LeoPersike/ProjetoAcionamentoLampadasRF/Manual de instruções.pdf

## Acionador automático de lâmpadas via RF

Projetista: Leonardo Persike Martins
Email: Leonardo.Persike.Martins@gmail.com

Descrição de funcionamento
O equipamento em questão se trata de um conjunto de dispositivos cujo comportamento baseia-se em um sensor de barreira, utilizado para a detecção de objetos que interrompem um feixe de luz infravermelha. Quando acionado, o dispositivo base envia um sinal de acionamento via rádio frequência para um totem contendo uma lâmpada, acionando assim a mesma por um determinado período de tempo. No caso do sistema em questão, foi planejada a utilização de dois totens, os quais serão acionados de forma aleatória e exclusiva (apenas um totem por vez).

## Sumário

Acionador automático de lâmpadas via RF | 1
Descrição de funcionamento | 1
Sumário | 1
Lista de componentes | 2
Ferramentas necessárias | 3
Diagrama de conexões | 4
Sensor de barreira - Receptor | 4
Sensor de barreira - Transmissor | 4
Totem Luz | 4
Instruções adicionais | 5
Totem de luz | 5
Transmissor e receptor RF | 5
Antena | 5
Programação do microcontrolador | 6
Preparando a interface Arduino | 6
Programando | 6
Baixando o código | 6
Preparação do sistema | 7
Inserindo código no relé | 7
Clonando código do controle no Arduino | 7

Acionador automático de lâmpadas via RF
Leonardo.Persike.Martins@gmail.com

## Lista de componentes

Os seguintes itens fazem parte de um sistema completo com 2 totens de luz:

Item | Qtd. | Link | Descrição
Placa Arduíno Nano | 1 | Arduíno (https://www.filipeflop.com/produto/placa-nano-v3-0-cabo-usb-para-arduino/) | Módulo contendo microcontrolador que servirá como inteligência do sistema.
Módulo Transmissor RF 433MHz | 1 | Módulo RF (https://www.filipeflop.com/produto/modulo-rf-transmissor-receptor-433mhz-am/) | Módulo RF que opera como um controle.
Antena 433MHz | 1 | Antena 433MHz (https://www.filipeflop.com/produto/antena-espiral-433mhz/) | Antena para ser soldada no módulo RF de forma a aumentar o alcance do mesmo.
Módulo Relé 2 (ou mais) canais controlado por RF | 2 | Relé (https://www.filipeflop.com/produto/modulo-rele-4-canais-interruptor-com-controle-remoto-rf-433mhz/) | Relés conectados aos totens de luz, de forma a receber e interpretar o sinal, acionando e desligando as luzes.
Módulo conversor de tensão 12V para 5V | 1 | Conversor (https://www.filipeflop.com/produto/conversor-step-down-9-36vdc-para-5v-6a-usb/) | Conversor para reduzir a tensão da bateria para 5V, de forma a alimentar os microcontroladores.
Sensor de barreira 12V | 1 | Sensor Barreira (https://www.magazineluiza.com.br/sensor-antiesmagamento-barreira-feixe-simples-ativo-ir15-ipec/p/ha85a4d629/cj/seps/) | Sensor de barreira para detectar a passagem do veículo.
Bateria 12V | 4 | Bateria (https://www.magazineluiza.com.br/bateria-selada-12v-13ah-nobreak-cerca-eletrica-alarmes-relogio-de-ponto-balancas-secpower/p/hcc62h2gfb/au/otau/) | Bateria para alimentar os sistemas.
Módulo carregador de bateria 12V | 4 | Carregador (https://www.magazineluiza.com.br/modulo-fonte-flex-carregador-bateria-12v-emergencia-boosmce/p/fk2gdcaa43/te/cdcl/) | Módulo para carregamento das baterias.
Fonte 12V | 4 | Fonte 12V (https://www.magazineluiza.com.br/fonte-carregador-12v-3a-plug-5-5x2-5-173/p/jda0aj47gc/te/cdcl/) | Fonte para carregar as baterias diretamente pela tomada.
Refletor LED 12V | 2 | Refletor (https://www.magazineluiza.com.br/kit-2-farol-milha-16-leds-48w-12v-24v-quadrado-off-road-6000k-ry/p/ek9cfg9e92/au/otau/) | Refletores que serão colocados nos totens.
Chave Liga/Desliga | 4 | Chave on off (https://www.filipeflop.com/produto/chave-gangorra-redonda-on-off-spst/) | Botão para ligar e desligar o sistema.
Conectores rápidos | 8 | Conector (https://www.filipeflop.com/produto/emenda-rapida-para-fios/) | Conector 2 vias para distribuição de cabos internamente.
Jumpers | 2 | Jumpers (https://www.filipeflop.com/produto/kit-jumpers-10cm-x120-unidades/) | Jumpers necessários para a interconexão entre componentes.
Cabo PP 2 vias | 2 | Cabo PP (https://www.magazineluiza.com.br/cabo-fio-pp-500v-2-vias-2x150mm-rolo-com-1-metros-sil/p/dgk4f2g6f4/cj/catr/) | Cabo 2.5mm (ou mais grosso) para distribuir a alimentação do sistema
Par de garras jacaré | 1 | Garras (https://www.magazineluiza.com.br/garra-jacare-35mm-isolado-preta-e-vermelha-10-pares-de-coracao-shop/p/jefka173kj/au/gjcr/) | Garras jacaré para conexão da bateria.

## Ferramentas necessárias

As seguintes ferramentas são necessárias para a montagem dos equipamentos.

Item | Link | Descrição
Ferro de solda | Ferro (https://www.magazineluiza.com.br/ferro-solda-soldar-estanho-60w-inmetro-127-220v-profissional-eda/p/dcbc94fe0g/fs/fdsa/) | Utilizado para soldar as garras jacarés nos cabos que vão para a bateria.
Estanho | Estanho (https://www.magazineluiza.com.br/estanho-fio-c-fluxo-10mm-tubinho-cobix/p/gj38ed20f8/in/pepc/) | Utilizado para soldar as garras jacarés nos cabos que vão para a bateria.
Alicate corte | Alicate (https://www.magazineluiza.com.br/alicate-de-corte-diagonal-profissional-mtx/p/cfed703fgb/fs/altd/) | Utilizado para descascar os cabos.
Chave philips | Kit (https://www.magazineluiza.com.br/conjunto-kit-de-chaves-de-precisao-25-pecas-ima-conserto-manutencao-de-celular-computador-notebook-chaves-universal/p/ddcf1fc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) | Utilizado para conectar os cabos aos conectores das placas.

## Diagrama de conexões

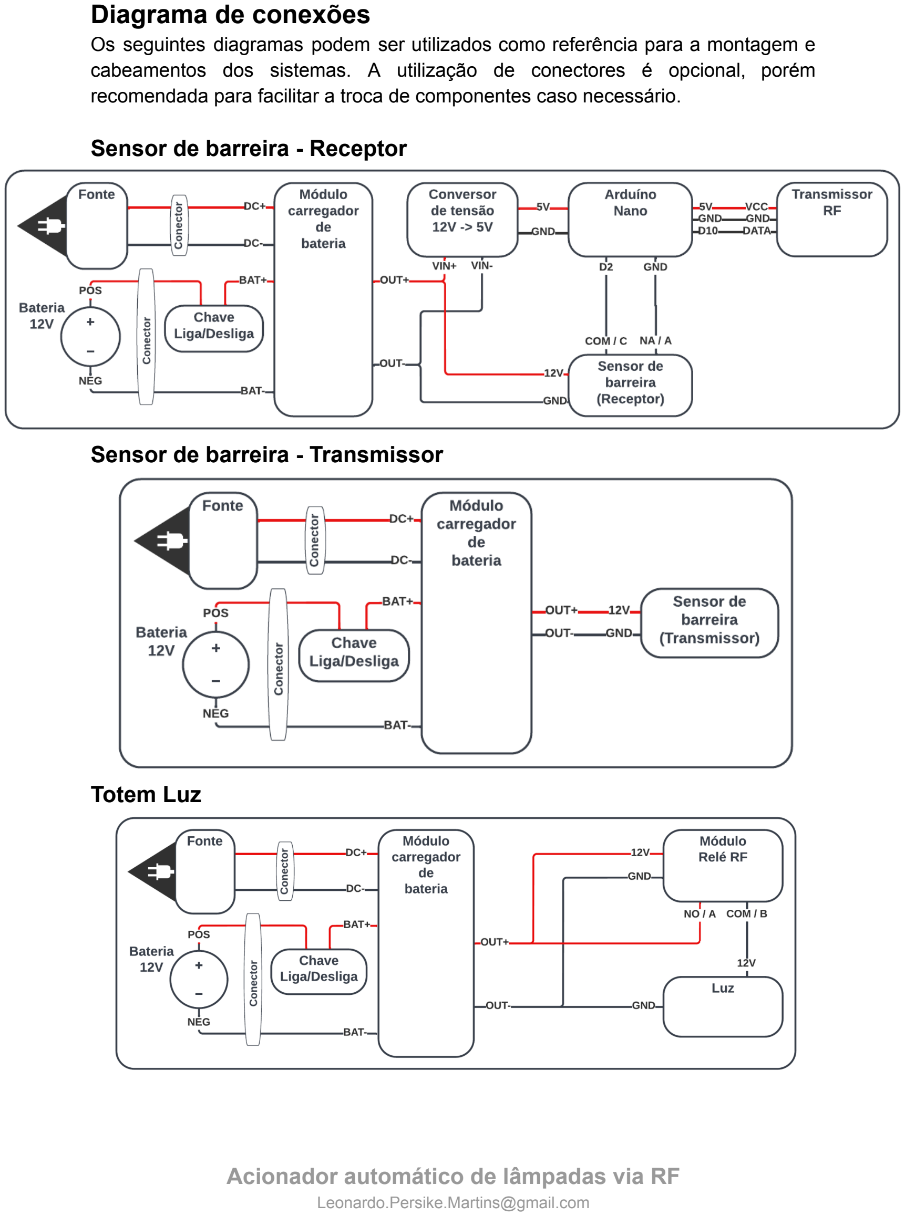
[picture p1: page 4]

Os seguintes diagramas podem ser utilizados como referência para a montagem e cabeamentos dos sistemas. A utilização de conectores é opcional, porém recomendada para facilitar a troca de componentes caso necessário.

Sensor de barreira - Receptor

Sensor de barreira - Transmissor

Totem Luz

Instruções adicionais
Totem de luz
O sistema tem a capacidade de acionamento de quatro totens de luz diferentes, devido a placa de relé conter 4 relés. Portanto, a conexão dos refletores devem seguir o seguinte diagrama:

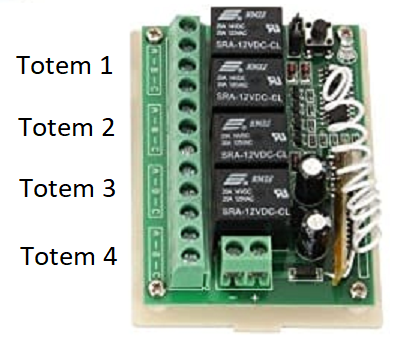
[picture p2: figure]

Transmissor e receptor RF
A seguinte imagem identifica os componentes:

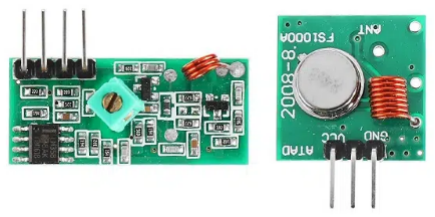
[picture p3: figure]

Receptor à esquerda. Transmissor à direita.

Antena
De forma a melhorar o alcance do módulo RF, é possível realizar a soldagem de uma antena simples no pino “ANT” do módulo transmissor, conforme indica a imagem a seguir:

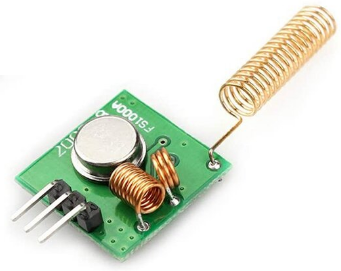
[picture p4: figure]

## Programação do microcontrolador

Preparando a interface Arduino
Para a programação dos microcontroladores será utilizada a interface de desenvolvimento (IDE) Arduino, que pode ser obtida através do seguinte link:
- https://www.arduino.cc/en/software

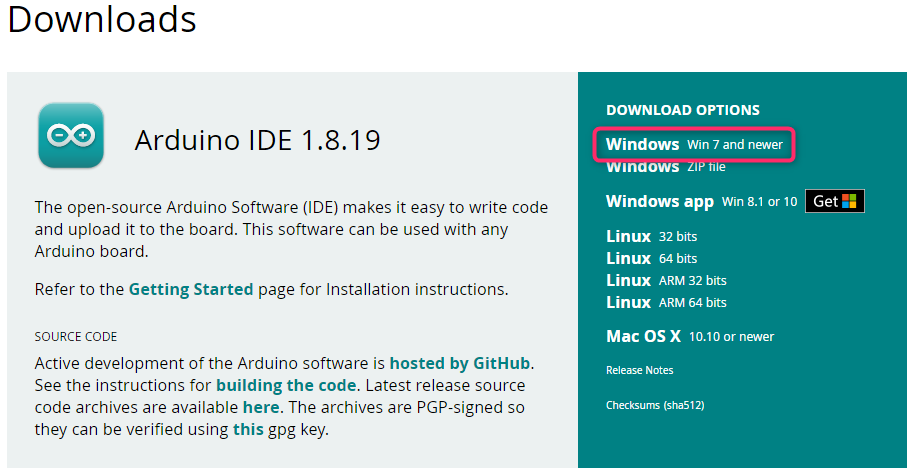
[picture p5: figure]

Programando
Para programar o microcontrolador é necessário uma conexão USB entre o dispositivo e o computador. Note que a programação pode ser feita antes de montar o sistema, facilitando assim o acesso ao conector USB da placa.

Baixando o código
- Abrir o site: https://github.com/LeoPersike/ProjetoAcionamentoLampadasRF
- Faça o download dos códigos clicando em “Code”->”Download Zip”
- Em seguida extraia o arquivo e abra a pasta “acionadorRF”
- Abra o software “Arduino” ou dê dois cliques no arquivo “acionadorRF.ino”

Programando o Arduino
- Conecte o Arduino com o cabo USB no PC
- Selecionar a placa arduino Nano: “Tools” -> “Board: xxx” -> Arduino Nano
- Selecionar a porta em que o dispositivo está conectado: “Tools” -> “Port” -> “COM X”
- Clicar em “Sketch” -> “Upload”
- A seguinte mensagem deverá aparecer:

## Preparação do sistema

Inserindo código no relé
Caso o relé forneça a opção de gravar códigos de novos controles, é possível fazer a gravação do código que já se encontra inserido no arduino. Para isto, ligue apenas o sistema “Sensor de barreira - Receptor”, o qual irá ficar simulando o aperto dos botões do controle. Em seguida, realize o procedimento de gravação de novo código no relé. No caso do relé utilizado neste projeto, as instruções são:
- Pressione o push-button presente na placa até que o led comece a piscar
- Pressione uma tecla do controle remoto
- O led irá piscar 2 vezes, indicando que a tecla foi gravada corretamente e está associada à 1 dos relés da placa
- Refaça o procedimento para as outra teclas do controle remoto
- Para apagar todos os códigos gravados, pressione o push-button por 8 segundos até que o led se apague

Se for utilizado um modelo diferente do apresentado neste documento, procure a informação de como gravar novos códigos no manual do mesmo.

Clonando código do controle no Arduino
Importante: apenas realize esse procedimento caso o relé não aceite gravação de novos códigos! Caso contrário, o arduino já possui um código para ser utilizado. Caso o relé não ofereça possibilidade de gravação de novos códigos, é possível clonar o controle que já está cadastrado utilizando o arduino. Para isto, você deverá montar o seguinte sistema:

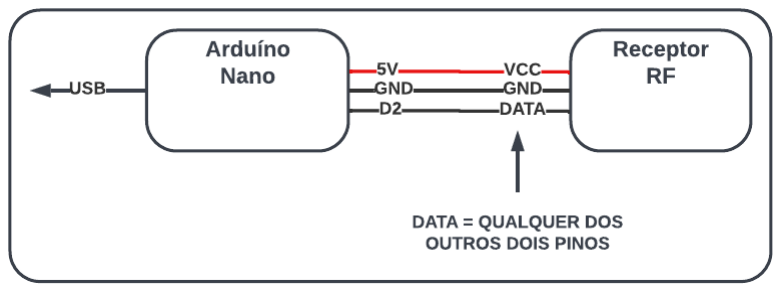
[picture p6: figure]

Em seguida, você deverá gravar o arduino com o seguinte arquivo:
- Abrir o site: https://github.com/LeoPersike/ProjetoAcionamentoLampadasRF
- Faça o download dos códigos clicando em “Code”->”Download Zip”
- Em seguida extraia o arquivo e abra a pasta “cloneRF”
- Abra o software “Arduino” ou dê dois cliques no arquivo “cloneRF.ino”
- Prossiga com a programação conforme explicado no capítulo anterior

- Em seguida você deverá abrir o monitor serial através do menu “Tools” -> “Serial Monitor”
- Aproxime o controle do módulo RF e aperte o primeiro botão. O código e parâmetros do primeiro deverão aparecer na tela
- Em seguida, aperta o segundo botão
- A imagem a seguir demonstra o resultado esperado:

Neste caso os parâmetros do controle utilizado foram os seguintes:
- Botão A:
- Código: 000101100010100100100001
- Pulse length: 286
- Protocol: 1
- Botão B:
- Código: 000101100010100100100010
- Pulse length: 286
- Protocol: 1

Descoberta a codificação do controle, é preciso alterar o código do arduino para simular o mesmo. Para isto, abra o arquivo “acionadorRF.ino” e altere as seguintes linhas conforme os parâmetros que foram encontrados:

Pronto. Agora basta você programar o arduíno com a nova codificação e o arduino irá simular o controle que já está cadastrado no relé.
