LeoPersike/ProjetoAcionamentoLampadasRF/(commit log)

2022-08-22 Adicionando arquivos do arduino.
2022-08-22 Adicionando manual de instruções.
